skot/TPS40305_Supply/doc/3d_preview.jpg

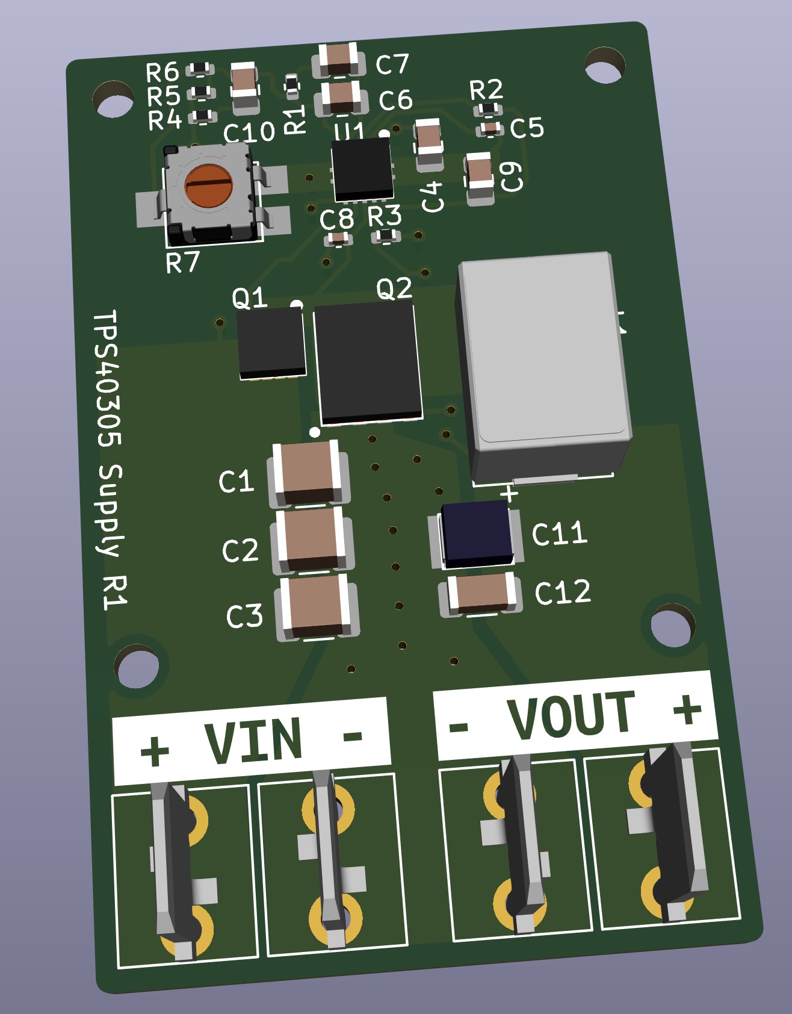
doc/3d_preview.jpg
