skot/TPS40305_Supply/README.md

# TPS40305 Supply
Texas Instruments TPS40305 based power supply.


Low voltage, high current buck controller.

- Input: DC 4V - 5.5V
- Output: adjustable between 1.38V and 1.66V using pot
- Output Current: 25A (at 1.5V)
- Seems to work!
