skot/TPS40305_Supply/TPS40305_supply BOM.xlsx

Sheet: TPS40305_supply
Qty | Reference(s) | Value | DK | PARTNO
3 | C1, C2, C3 | 47uF | 490-6539-1-ND | GRM32ER61C476KE15L
1 | C4 | 1uF | 1276-6471-1-ND
1 | C5 | 3.3nF | 1276-1552-1-ND
1 | C6 | 180pF | 311-1114-1-ND
1 | C7 | 1.5nF | 311-1128-1-ND
1 | C8 | 0.1uF | 1276-1043-1-ND
1 | C9 | 10uF | 1276-1096-1-ND
1 | C10 | 470pF | 1292-1580-1-ND
1 | C11 | 220uF | P16200CT-ND | 2R5TPE220MAFB
1 | C12 | 100uF | 445-6008-1-ND | C3216X5R0J107M160AB
4 | J1, J2, J3, J4 | Conn_01x01 | A100886CT-ND | 63862-1
1 | L1 | 150nH | 513-1568-1-ND | FP1005R1-R15-R
1 | Q1 | CSD16340Q3 | 296-25646-1-ND | CSD16340Q3
1 | Q2 | CSD17311Q5 | 296-27625-1-ND | CSD17311Q5
1 | R1 | 3.83k | 311-3.83KLRCT-ND
1 | R2 | 100k | 311-100KJRCT-ND
1 | R3 | 4.12k | RMCF0402FT4K12CT-ND
1 | R4 | 1.33k | 311-1.33KLRCT-ND
1 | R5 | 10k | 311-10KJRCT-ND
1 | R6 | 5.62k | RMCF0402FT5K62CT-ND
1 | R7 | 2k | ST4ETB202CT-ND | ST4ETB202
1 | U1 | TPS40305 | 296-25487-1-ND | TPS40305DRCT

Sheet: DK Order
Qty | Reference(s) | DK
3 | C1, C2, C3 | 490-6539-1-ND
1 | C4 | 1276-6471-1-ND
1 | C5 | 1276-1552-1-ND
1 | C6 | 311-1114-1-ND
1 | C7 | 311-1128-1-ND
1 | C8 | 1276-1043-1-ND
1 | C9 | 1276-1096-1-ND
1 | C10 | 1292-1580-1-ND
1 | C11 | P16200CT-ND
1 | C12 | 445-6008-1-ND
4 | J1, J2, J3, J4 | A100886CT-ND
1 | L1 | 513-1568-1-ND
1 | Q1 | 296-25646-1-ND
1 | Q2 | 296-27625-1-ND
1 | R1 | 311-3.83KLRCT-ND
1 | R2 | 311-100KJRCT-ND
1 | R3 | RMCF0402FT4K12CT-ND
1 | R4 | 311-1.33KLRCT-ND
1 | R5 | 311-10KJRCT-ND
1 | R6 | RMCF0402FT5K62CT-ND
1 | R7 | ST4ETB202CT-ND
1 | U1 | 296-25487-1-ND
