skot/TPS40305_Supply/3D/DQH0008A.stp

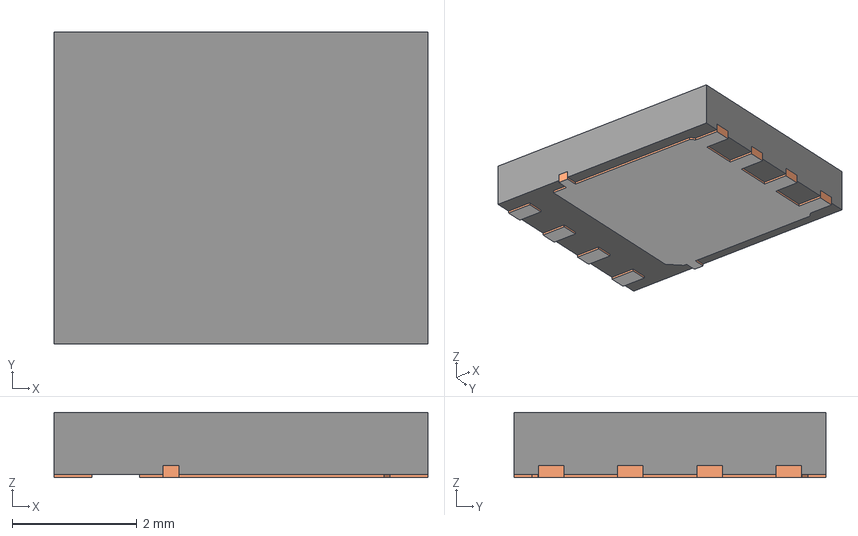
[picture p2: CAD file, 2022-10-03]
3D/DQH0008A.stp
6.00 x 5.00 x 1.05 mm
BODY-SON
FRAME-DQH0008A
PIN1-ID
