skot/TPS40305_Supply/3D/DRC0010J.stp

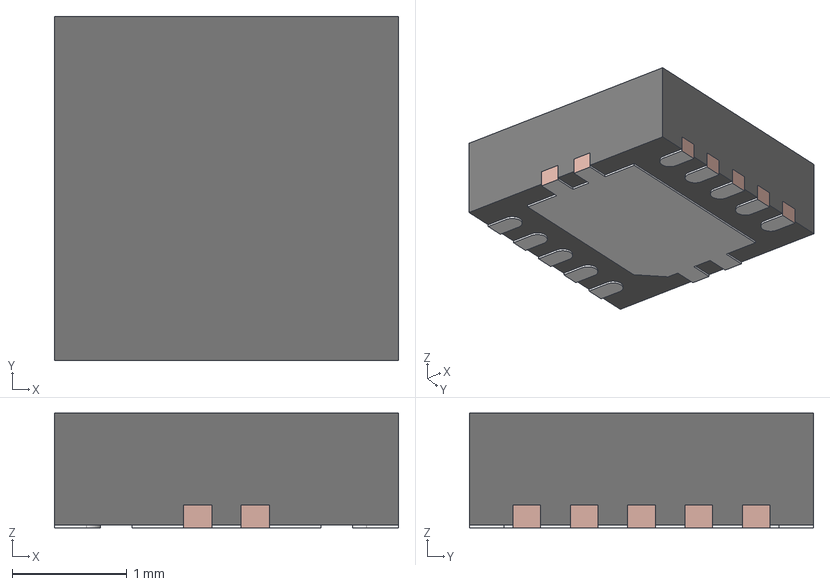
[picture p3: CAD file, 2022-10-03]
3D/DRC0010J.stp
3.00 x 3.00 x 1.00 mm
BODY-SON
FRAME-DRC0010J
