skot/TPS40305_Supply/3D/DQG0008A.stp

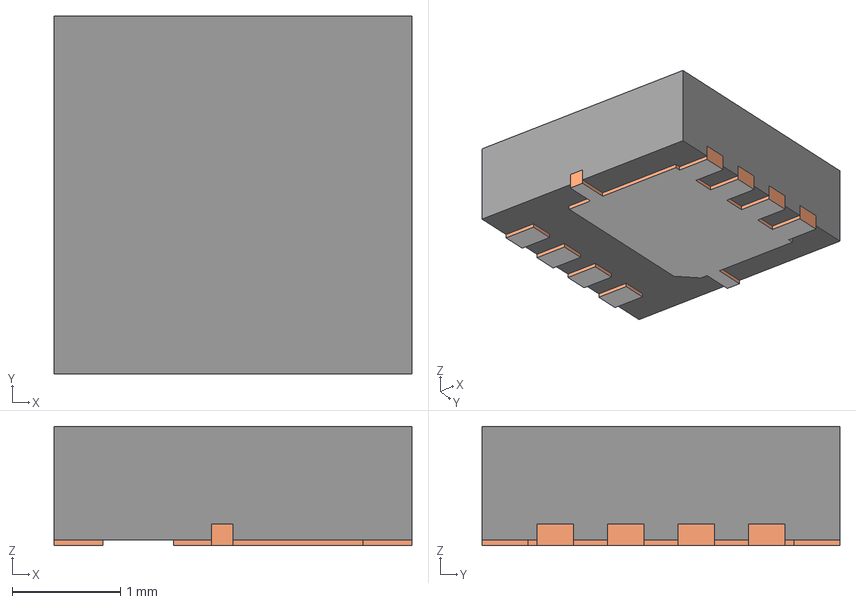
[picture p5: CAD file, 2022-10-03]
3D/DQG0008A.stp
3.30 x 3.30 x 1.10 mm
BODY-SON
FRAME-DQG0008A
PIN1-ID
