skot/TPS40305_Supply/3D/c-63862-1-r-3d.stp

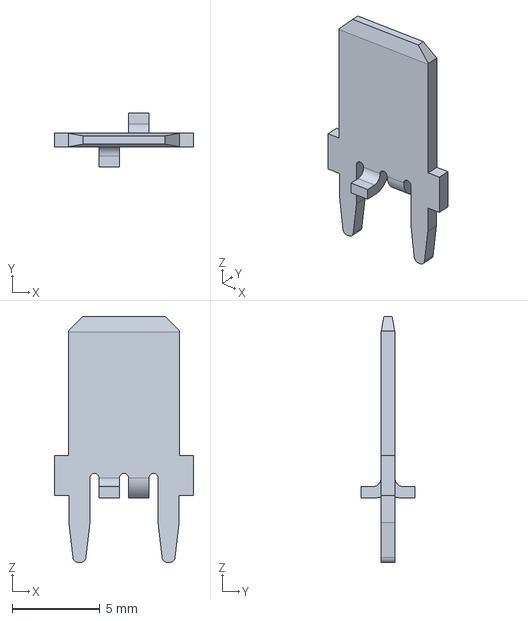
[picture p7: CAD file, 2022-09-30]
3D/c-63862-1-r-3d.stp
7.92 x 3.07 x 14.0 mm
