skot/TPS40305_Supply/3D/2R5TPE220MAFB.step

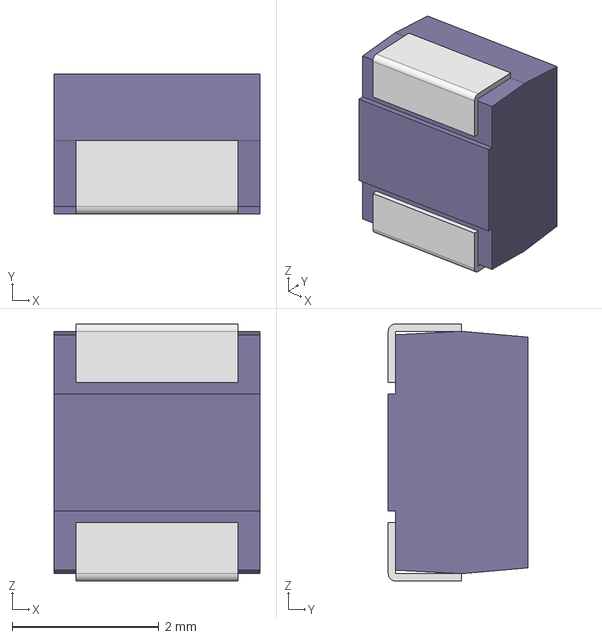
[picture p8: CAD file, 2022-09-30]
3D/2R5TPE220MAFB.step
2.80 x 1.90 x 3.50 mm
mold-B2
flame-B2 x 2
