skot/TPS40305_Supply/TPS40305_supply.kicad_pcb

## KiCad design TPS40305_supply.kicad_pcb (2022-10-04)

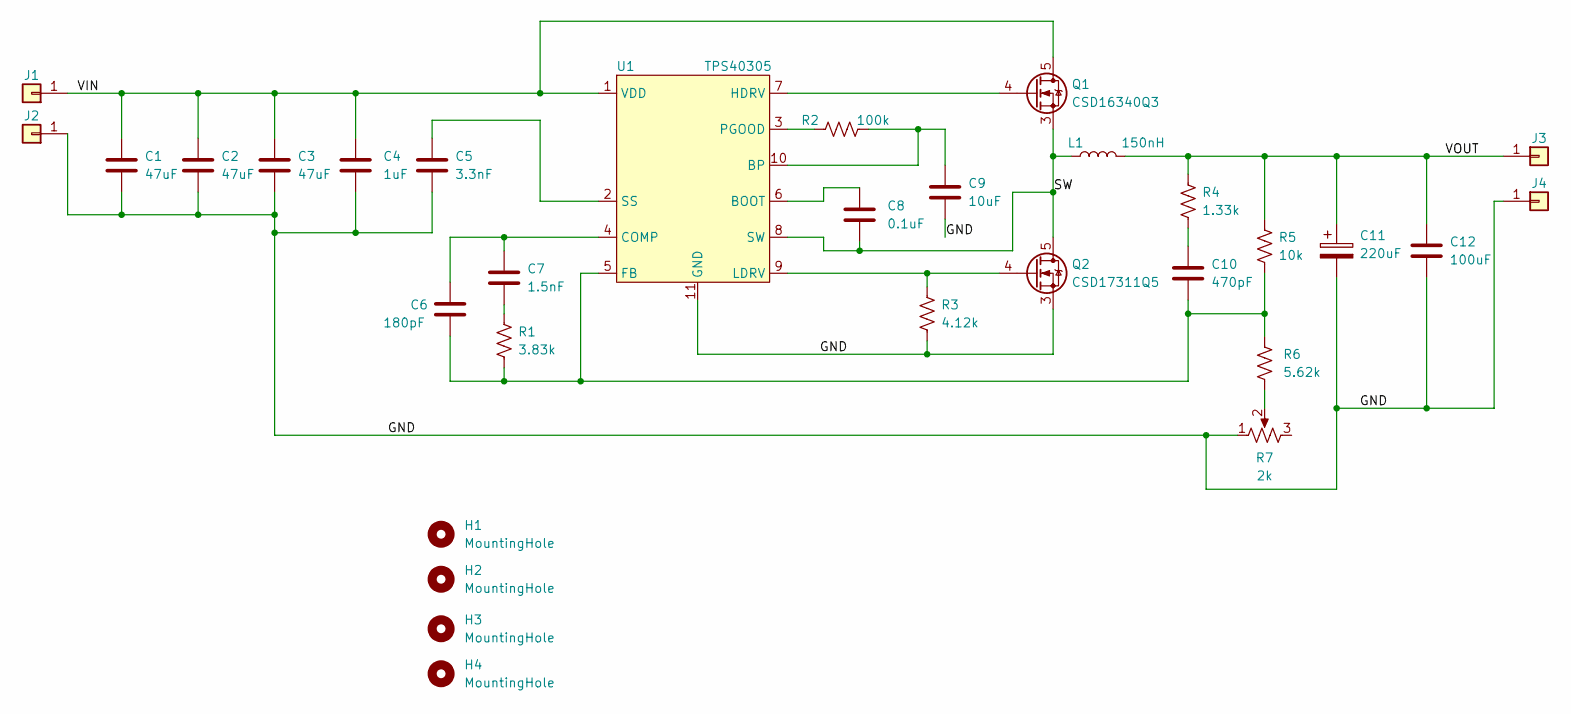
[picture p9: schematic TPS40305_supply.kicad_sch]

Parts:
C1, C2, C3: 47uF; C_1210_3225Metric; PARTNO GRM32ER61C476KE15L
C4: 1uF; C_0805_2012Metric
C5: 3.3nF; C_0402_1005Metric
C6: 180pF; C_0805_2012Metric
C7: 1.5nF; C_0805_2012Metric
C8: 0.1uF; C_0402_1005Metric
C9: 10uF; C_0805_2012Metric
C10: 470pF; C_0805_2012Metric
C11: 220uF; CAP_2R5TPE220MAFB; PARTNO 2R5TPE220MAFB
C12: 100uF; C_1206_3216Metric; PARTNO C3216X5R0J107M160AB
H1, H2, H3, H4: MountingHole; MountingHole_2.2mm_M2
J1, J2, J3, J4: Conn_01x01; 63862-1; PARTNO 63862-1
L1: 150nH; FP1005R1-R15-R; PARTNO FP1005R1-R15-R
Q1: CSD16340Q3; PARTNO CSD16340Q3
Q2: CSD17311Q5; PARTNO CSD17311Q5
R1: 3.83k; R_0402_1005Metric
R2: 100k; R_0402_1005Metric
R3: 4.12k; R_0402_1005Metric
R4: 1.33k; R_0402_1005Metric
R5: 10k; R_0402_1005Metric
R6: 5.62k; R_0402_1005Metric
R7: 2k; ST4ETB202; PARTNO ST4ETB202
U1: TPS40305; PARTNO TPS40305DRCT

Connections:
/GND: C1.2, C2.2, C3.2, C4.2, C5.2, C9.2, C11.2, C12.2, J2.1, J4.1, Q2.1, Q2.2, Q2.3 (S), R3.2, R7.1, U1.11 (GND)
/SW: C8.2, L1.1, Q1.1, Q1.2, Q1.3 (S), Q2.5 (D), U1.8 (SW)
/VIN: C1.1, C2.1, C3.1, C4.1, J1.1, Q1.5 (D), U1.1 (VDD)
/VOUT: C11.1, C12.1, J3.1, L1.2, R4.1, R5.1
unnamed: C5.1, U1.2 (SS)
unnamed: C6.1, C7.1, U1.4 (COMP)
unnamed: C7.2, R1.1
unnamed: C8.1, U1.6 (BOOT)
unnamed: C9.1, R2.2, U1.10 (BP)
unnamed: C10.1, R4.2
unnamed: C6.2, C10.2, R1.2, R5.2, R6.1, U1.5 (FB)
unnamed: Q1.4 (G), U1.7 (HDRV)
unnamed: Q2.4 (G), R3.1, U1.9 (LDRV)
unnamed: R2.1, U1.3 (PGOOD)
unnamed: R6.2, R7.2

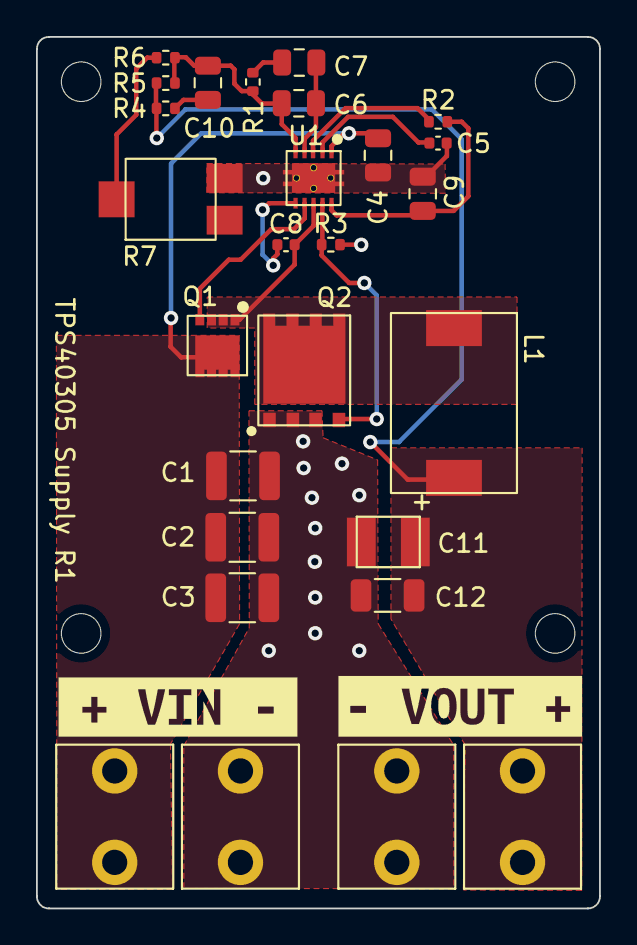
[picture p10: board TPS40305_supply.kicad_pcb from above]

Board: 2 copper layers, 31.3 x 48.4 mm, 33 parts (0 on the bottom side), 15 nets.

Other parts of the board:
kibuzzard-633B51DB: G***; kibuzzard-633B51DB
kibuzzard-633B5210: G***; kibuzzard-633B5210
