skot/TPS40305_Supply/(commit log)

2022-09-13 initial import
    [TPS40305_supply.kicad_pcb, TPS40305_supply.kicad_sch]
2022-09-13 added the jellybean footprints
    [TPS40305_supply.kicad_sch]
2022-09-13 started on some of the mosfet footprints
    [TPS40305_supply.kicad_sch]
2022-09-30 added footprints
    [2R5TPE220MAFB.step, TPS40305_supply.kicad_pcb, TPS40305_supply.kicad_sch]
2022-09-30 added spade connectors ("we need a spade if we're gonna dig a pit.")
    [TPS40305_supply.kicad_pcb, TPS40305_supply.kicad_sch, c-63862-1-r-3d.stp]
2022-09-30 fixed problem with mosfet pad
    [TPS40305_supply.kicad_pcb]
2022-10-03 more layout
    [TPS40305_supply.kicad_pcb, TPS40305_supply.kicad_sch]
2022-10-03 initial layout and routing complete
    [TPS40305_supply.kicad_pcb]
2022-10-03 added silkscreen and 3D part CAD files
    [DQG0008A.stp, DQH0008A.stp, DRC0010J.stp, FP1006V2-R.STEP, ST-4ETB2k_(202).stp, TPS40305_supply.kicad_pcb]
2022-10-04 added DK part numbers and generated BOM
    [TPS40305_supply BOM.xlsx, TPS40305_supply.kicad_pcb, TPS40305_supply.kicad_sch]
2022-10-04 added gerbers
    [TPS40305_supply-B_Cu.gbr, TPS40305_supply-B_Mask.gbr, TPS40305_supply-B_Silkscreen.gbr, TPS40305_supply-Edge_Cuts.gbr, TPS40305_supply-F_Cu.gbr, TPS40305_supply-F_Mask.gbr, TPS40305_supply-F_Paste.gbr, TPS40305_supply-F_Silkscreen.gbr]
2022-10-04 updated busted DK PN
    [TPS40305_supply BOM.xlsx, TPS40305_supply.kicad_sch]
2022-10-04 updated preview pic with mounting holes
2022-10-25 readme update after building R1 boards
    [TPS40305_supply.kicad_sch]
