skot/TPS40305_Supply/(notices)

Notices in the files:
3D/ST-4ETB2k_(202).stp:
author */ ('License CC BY-ND 4.0'),
